ubco-cscott/499/README.md

# 499 Capstone Project - Group 16
Connor, Ellis, Nathan, Sarah, Sean
