ubco-cscott/499/PCB Files/406MHz detector/406MHz detector.pdf

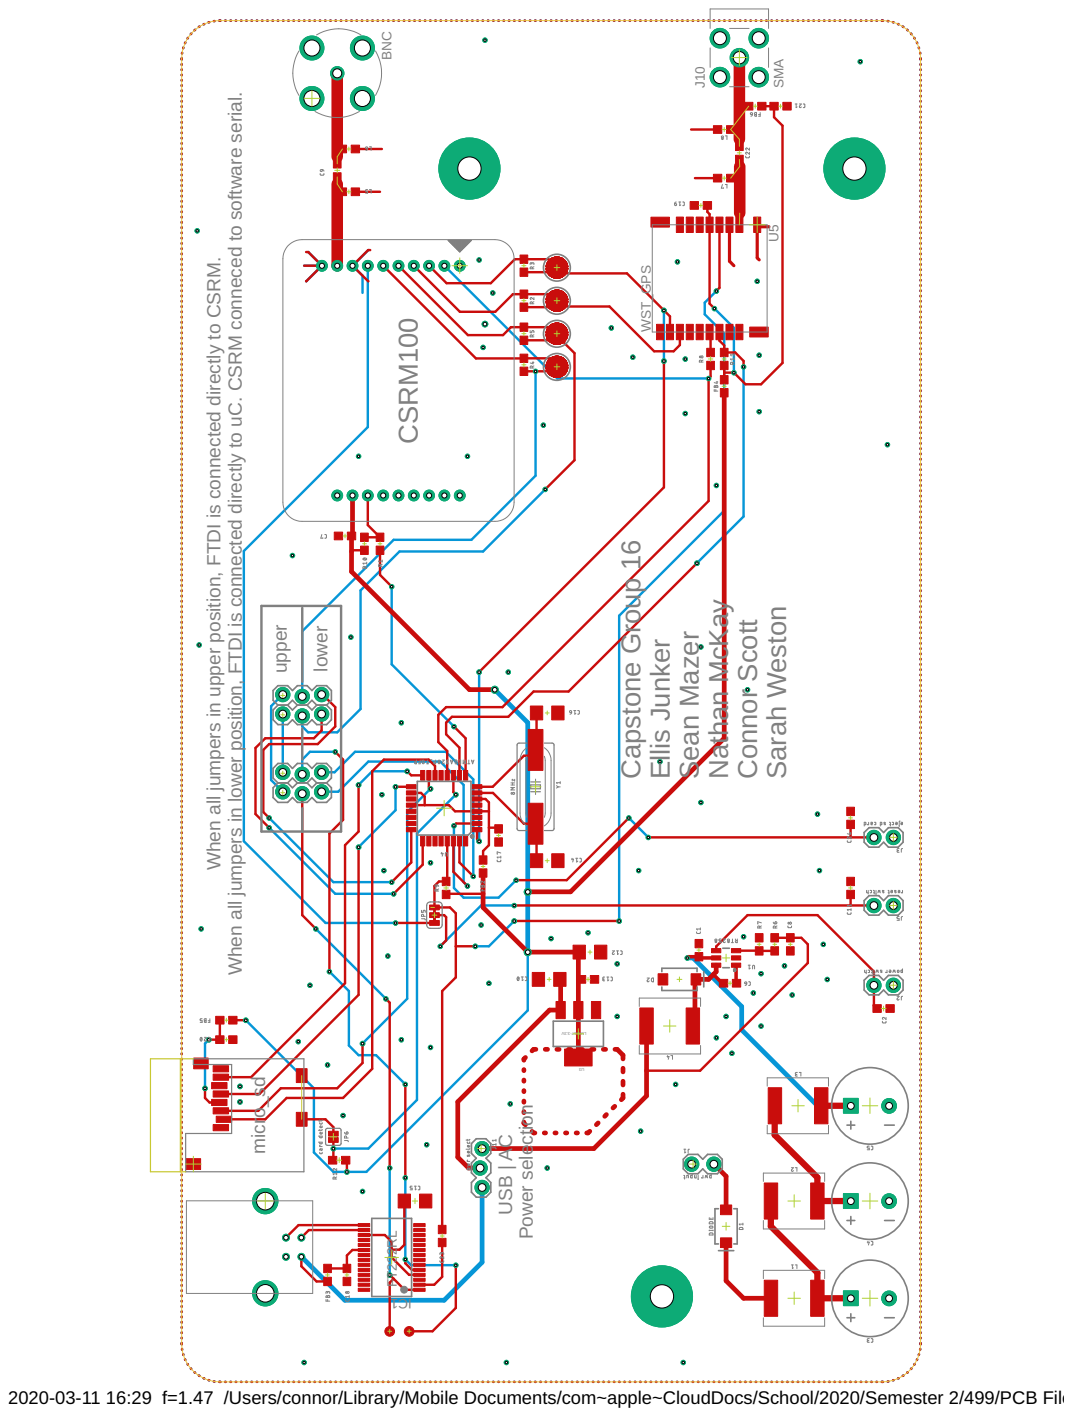
[picture p1: page 1]

er When all jum

2020-03-11 16:29 f=1.47 /Users/connor/Library/Mobile Documents/com~apple~CloudDocs/School/2020/Semester 2/499/PCB Files/406MHz detector/406MHz detector.brd
