ubco-cscott/499/PCB Files/406MHz detector/406MHz detector.brd

## EAGLE design PCB Files/406MHz detector/406MHz detector.brd (2020-03-17)

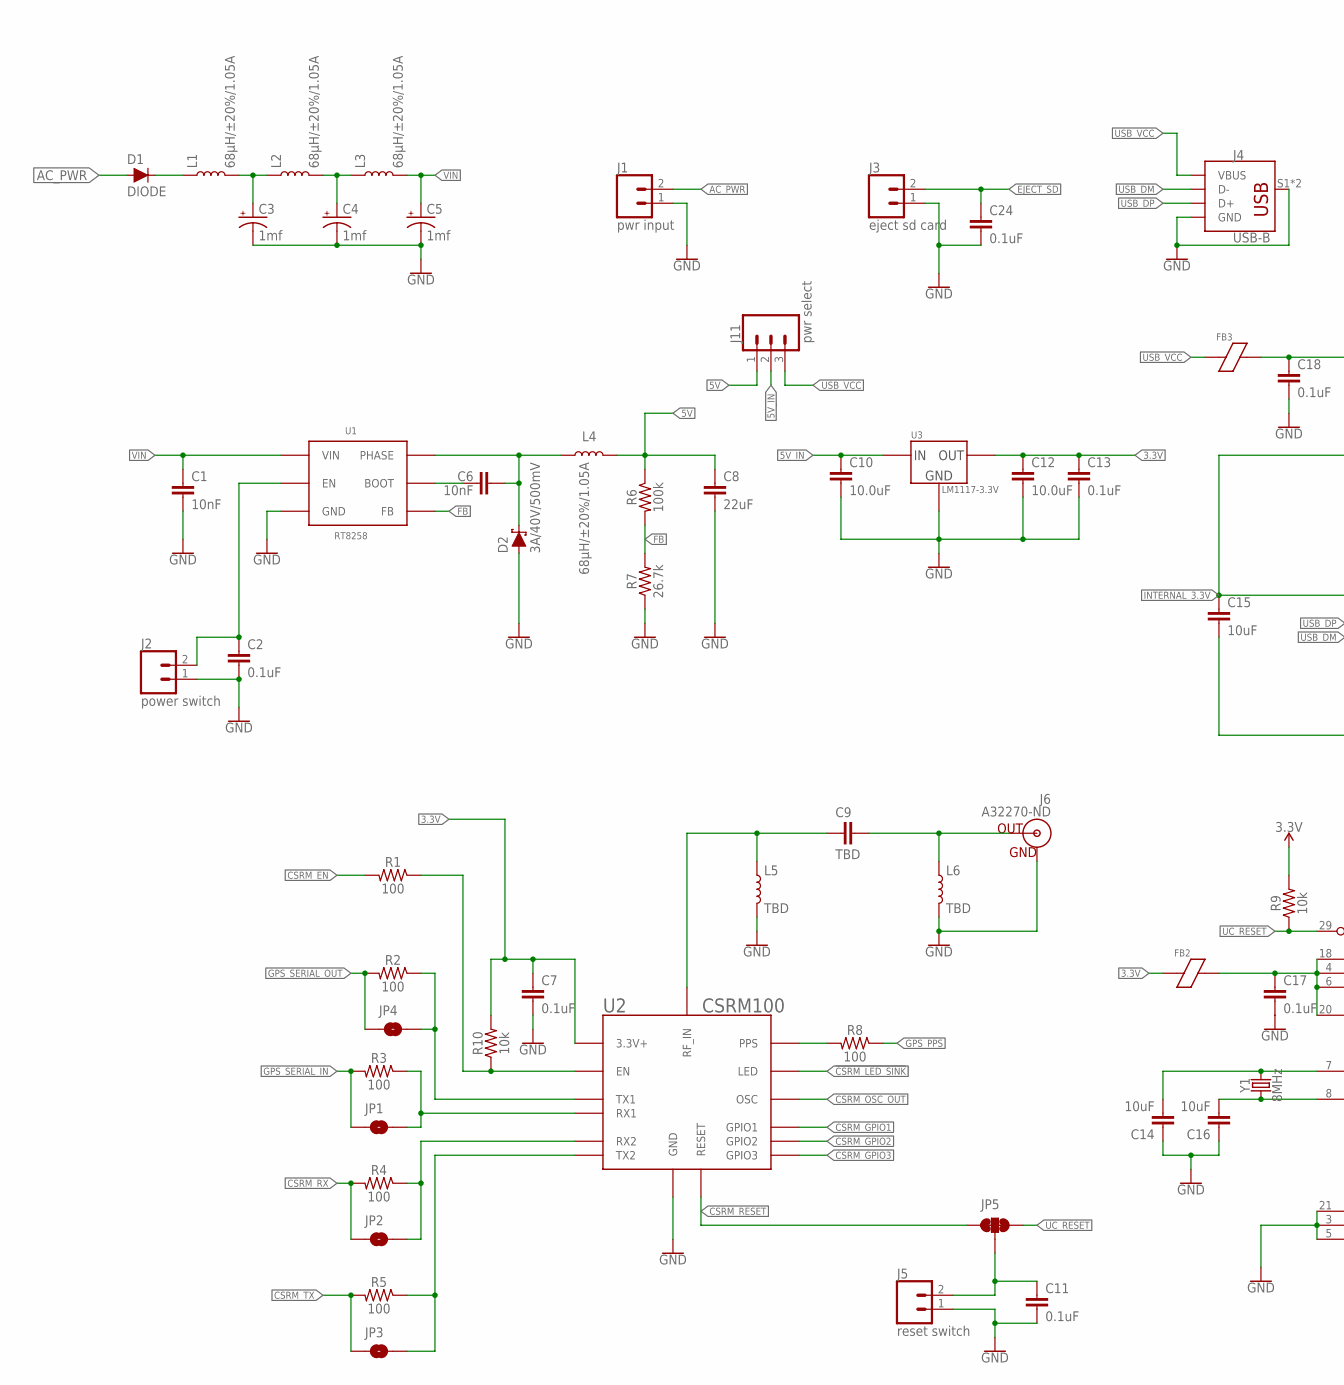
[picture p2: schematic 406MHz detector.sch, part in row 1, column 1]

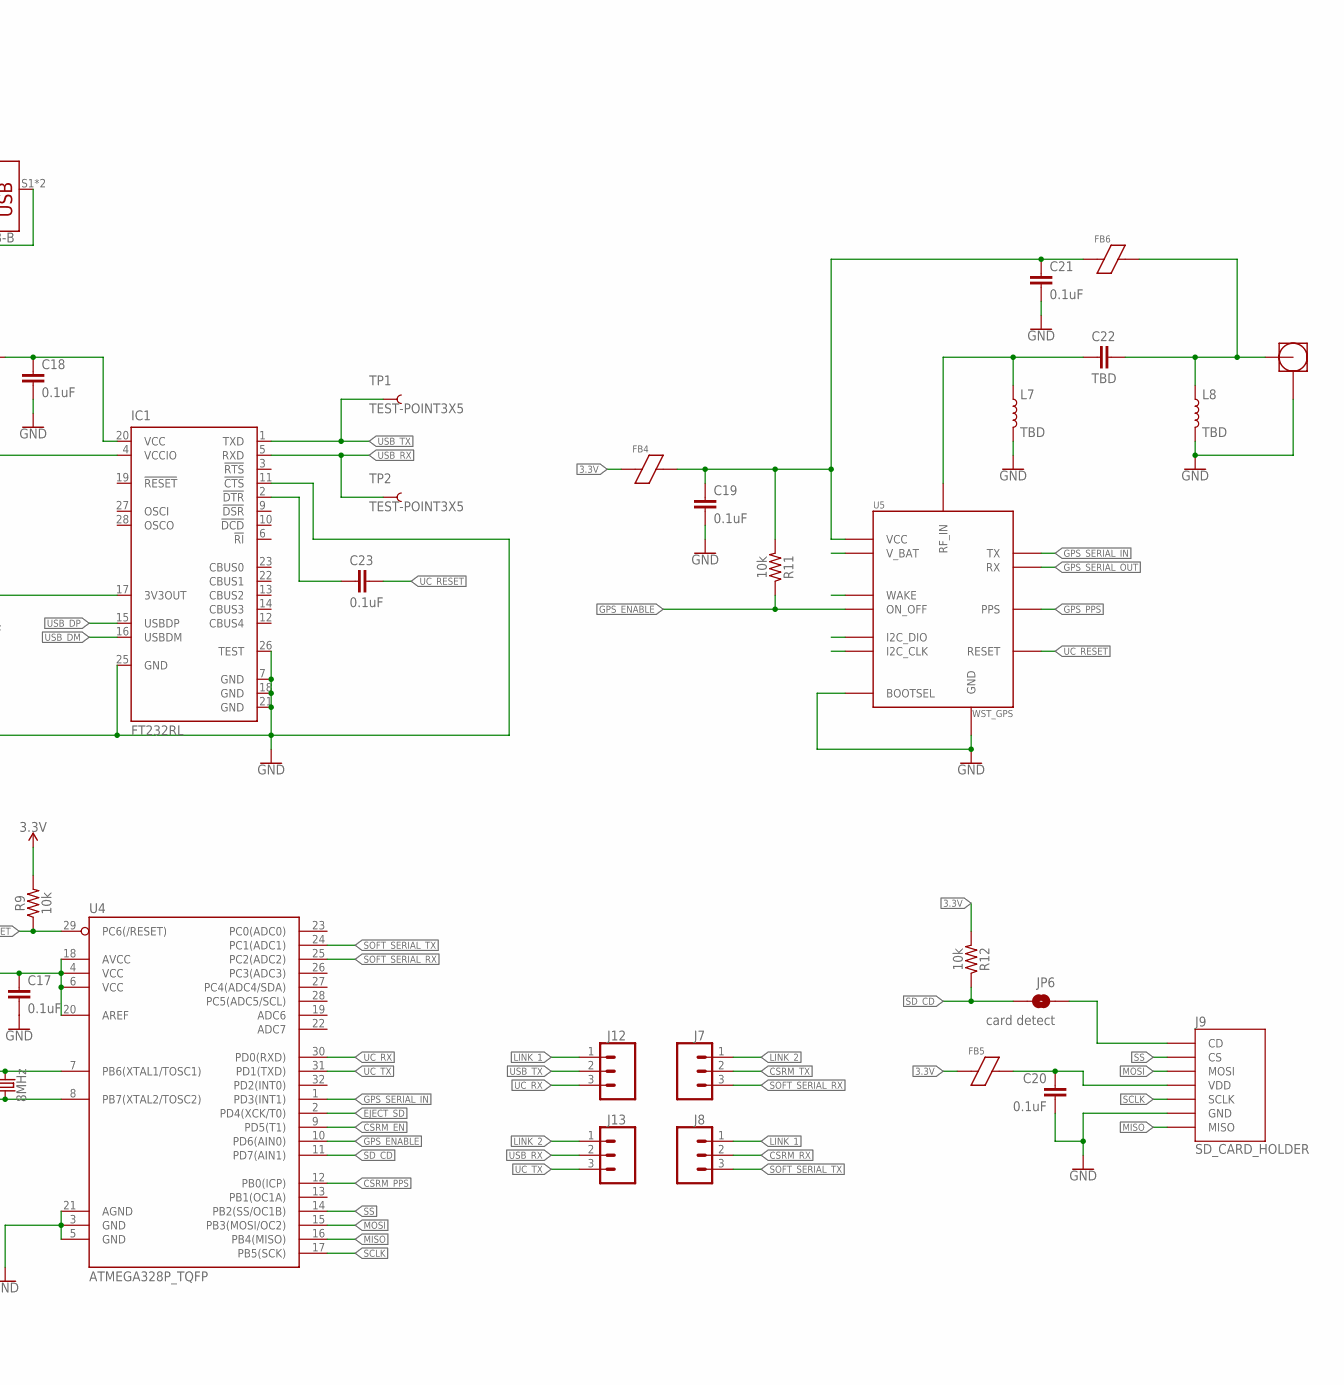
[picture p3: schematic 406MHz detector.sch, part in row 1, column 2]

Parts:
C1, C6: 10nF; 0603
C2, C7, C11, C13, C17, C18, C19, C20, C21, C23, C24: 0.1uF; 0603
C3, C4, C5: 1mf; CPOL-RADIAL-5MM-10MM-KIT
C8: 22uF; 0603
C9, C22: TBD; 0603
C10, C12: 10.0uF; 1206
C14, C15, C16: 10uF; 1206
D1: DIODE; SMA-DIODE
D2: 3A/40V/500mV; SMA-DIODE
FB2, FB3, FB4, FB5, FB6: FERRITE_BEAD; 0603
IC1: FT232RL; SSOP28
J1: pwr input; 1X02_LOCK
J2: power switch; 1X02
J3: eject sd card; 1X02
J4: USB-B; USB
J5: reset switch; 1X02
J6: A32270-ND; A33270-ND
J7, J8, J12, J13: select jumper; 1X03_LOCK
J9: SD_CARD_HOLDER
J10: SMA; SMA_R/A
J11: pwr select; 1X03_LOCK
JP1, JP2, JP3, JP4: JUMPER-SMT_2_NO_SILK_ROUND; SMT-JUMPER_2_NO_SILK_ROUND
JP5: JUMPER-SMT_3_2-NC_TRACE_SILK; SMT-JUMPER_3_2-NC_TRACE_SILK
JP6: card detect; SMT-JUMPER_2_NO_SILK
L1, L2, L3, L4: 68µH/±20%/1.05A; CR75
L5, L6, L7, L8: TBD; 0603
R1, R2, R3, R4, R5, R8: 100; 0603
R6: 100k; 0603
R7: 26.7k; 0603
R9, R10, R11, R12: 10k; 0603
TP1, TP2: TEST-POINT3X5; PAD.03X.05
U1: RT8258; SOT23-6
U2: CSRM100; CSRM
U3: LM1117-3.3V; SOT223
U4: ATMEGA328P_TQFP; TQFP32-08
U5: WST_GPS
Y1: 8MHz; HC49UP

Connections:
3.3V: C7.1, C12.1, C13.1, FB2.1, FB4.1, FB5.1, R9.2, R10.2, R12.2, U2.PWR_IN (3.3V+), U3.2 (VOUT), U3.4 (VOUT)
5V: C8.1, J11.1, L4.P$2 (2), R6.1
5V_IN: C10.1, J11.2, U3.3 (VIN)
406_IN: C9.2, L5.1, U2.406_IN (RF_IN)
!CSRM_LED_SINK: U2.LED
AC_PWR: D1.A, J1.2
ANTENNA_CONNECTOR: C9.1, J6.OUT, L6.1
BOOT: C6.1, U1.1 (BOOT)
CSRM_EN: R1.2, U4.9 (PD5(T1))
CSRM_GPIO1: U2.GPIO1
CSRM_GPIO2: U2.GPIO2
CSRM_GPIO3: U2.GPIO3
CSRM_OSC_OUT: U2.OSC_OUT (OSC)
CSRM_PPS: R8.2, U2.PPS, U4.12 (PB0(ICP))
CSRM_RESET: JP5.1, U2._RESET (RESET)
CSRM_RX: J8.2, JP2.1, R4.2
CSRM_TX: J7.2, JP3.1, R5.2
EJECT_SD: C24.1, J3.2, U4.2 (PD4(XCK/T0))
FB: R6.2, R7.2, U1.3 (FB)
GND: C1.2, C2.2, C3.-, C4.-, C5.-, C7.2, C8.2, C10.2, C11.2, C12.2, C13.2, C14.1, C15.2, C16.1, C17.2, C18.2, C19.2, C20.2, C21.2, C24.2, D2.A, IC1.7 (GND), IC1.11 (!CTS), IC1.18 (GND), IC1.21 (GND), IC1.25 (GND), IC1.26 (TEST), J1.1, J2.1, J3.1, J4.4 (GND), J4.S1 (SHIELD), J4.S2 (SHIELD), J5.1, J6.GND1 (GND), J6.GND2 (GND), J6.GND3 (GND), J6.GND4 (GND), J9.GND1 (GND), J9.GND2 (GND), J9.P6 (GND), J10.P$2, J10.P$3, J10.P$4, J10.P$5, L5.2, L6.2, L7.2, L8.2, R7.1, U1.2 (GND), U2.GND, U2.GND1 (GND), U2.GND2 (GND), U2.GND3 (GND), U2.GND4 (GND), U3.1 (GND), U4.3 (GND), U4.5 (GND), U4.21 (AGND), U5.P$1 (GND), U5.P$3 (GND), U5.P$9 (BOOTSEL), U5.P$17 (GND), U5.P$18 (GND), U5.P$19 (GND)
GPS_ANTENNA: C22.2, L7.1, U5.P$2 (RF_IN)
GPS_CONNECTOR: C22.1, FB6.2, J10.P$1, L8.1
GPS_ENABLE: R11.1, U4.10 (PD6(AIN0)), U5.P$15 (ON_OFF)
GPS_PPS: R8.1, U5.P$14 (PPS)
GPS_SERIAL_IN: JP1.1, R3.2, U4.1 (PD3(INT1)), U5.P$10 (TX)
GPS_SERIAL_OUT: JP4.1, R2.2, U5.P$11 (RX)
HF_SWITCH: C6.2, D2.C, L4.P$1 (1), U1.6 (PHASE)
INTERNAL_3.3V: C15.1, IC1.4 (VCCIO), IC1.17 (3V3OUT)
LINK_1: J8.1, J12.1
LINK_2: J7.1, J13.1
MISO: J9.P7 (MISO), U4.16 (PB4(MISO))
MOSI: J9.P3 (MOSI), U4.15 (PB3(MOSI/OC2))
unnamed: JP4.2, R2.1, U2.TX1
unnamed: JP1.2, R3.1, U2.RX1
unnamed: JP2.2, R4.1, U2.RX2
unnamed: JP3.2, R5.1, U2.TX2
unnamed: R1.1, R10.1, U2.EN
unnamed: C23.1, IC1.2 (!DTR)
unnamed: J9.CD1 (CD), J9.CD2 (CD), JP6.1
unnamed: D1.C, L1.P$1 (1)
unnamed: C3.+, L1.P$2 (2), L2.P$1 (1)
unnamed: C4.+, L2.P$2 (2), L3.P$1 (1)
unnamed: C18.1, FB3.1, IC1.20 (VCC)
unnamed: C14.2, U4.7 (PB6(XTAL1/TOSC1)), Y1.2
unnamed: C16.2, U4.8 (PB7(XTAL2/TOSC2)), Y1.1
unnamed: C19.1, C21.1, FB4.2, FB6.1, R11.2, U5.P$5 (VCC)
unnamed: C17.1, FB2.2, U4.4 (VCC), U4.6 (VCC), U4.18 (AVCC), U4.20 (AREF)
unnamed: C20.1, FB5.2, J9.P4 (VDD)
RESET: C11.1, J5.2, JP5.2
SCLK: J9.P5 (SCLK), U4.17 (PB5(SCK))
SD_CD: JP6.2, R12.1, U4.11 (PD7(AIN1))
SOFT_SERIAL_RX: J7.3, U4.25 (PC2(ADC2))
SOFT_SERIAL_TX: J8.3, U4.24 (PC1(ADC1))
SS: J9.P2 (CS), U4.14 (PB2(SS/OC1B))
SUPPLY_ENABLE: C2.1, J2.2, U1.4 (EN)
UC_RESET: C23.2, JP5.3, R9.1, U4.29 (PC6(/RESET)), U5.P$4 (RESET)
UC_RX: J12.3, U4.30 (PD0(RXD))
UC_TX: J13.3, U4.31 (PD1(TXD))
USB_DM: IC1.16 (USBDM), J4.2 (D-)
USB_DP: IC1.15 (USBDP), J4.3 (D+)
USB_RX: IC1.5 (RXD), J13.2, TP2.P$1
USB_TX: IC1.1 (TXD), J12.2, TP1.P$1
USB_VCC: FB3.2, J4.1 (VBUS), J11.3
VIN: C1.1, C5.+, L3.P$2 (2), U1.5 (VIN)

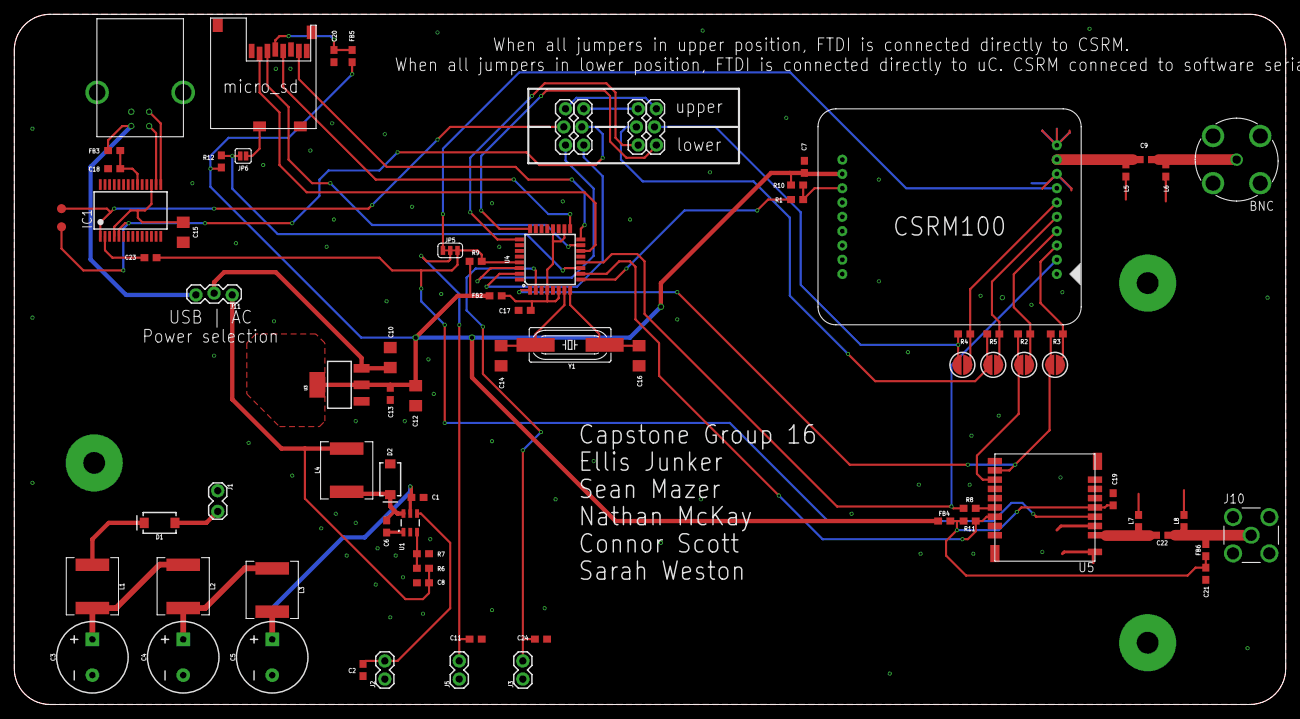
[picture p4: board 406MHz detector.brd from above]

Board: 2 copper layers, 177.8 x 96.5 mm, 79 parts (0 on the bottom side), 59 nets.
