ubco-cscott/499/Switching regulator test board/smps test.brd

## EAGLE design Switching regulator test board/smps test.brd (2020-01-20)

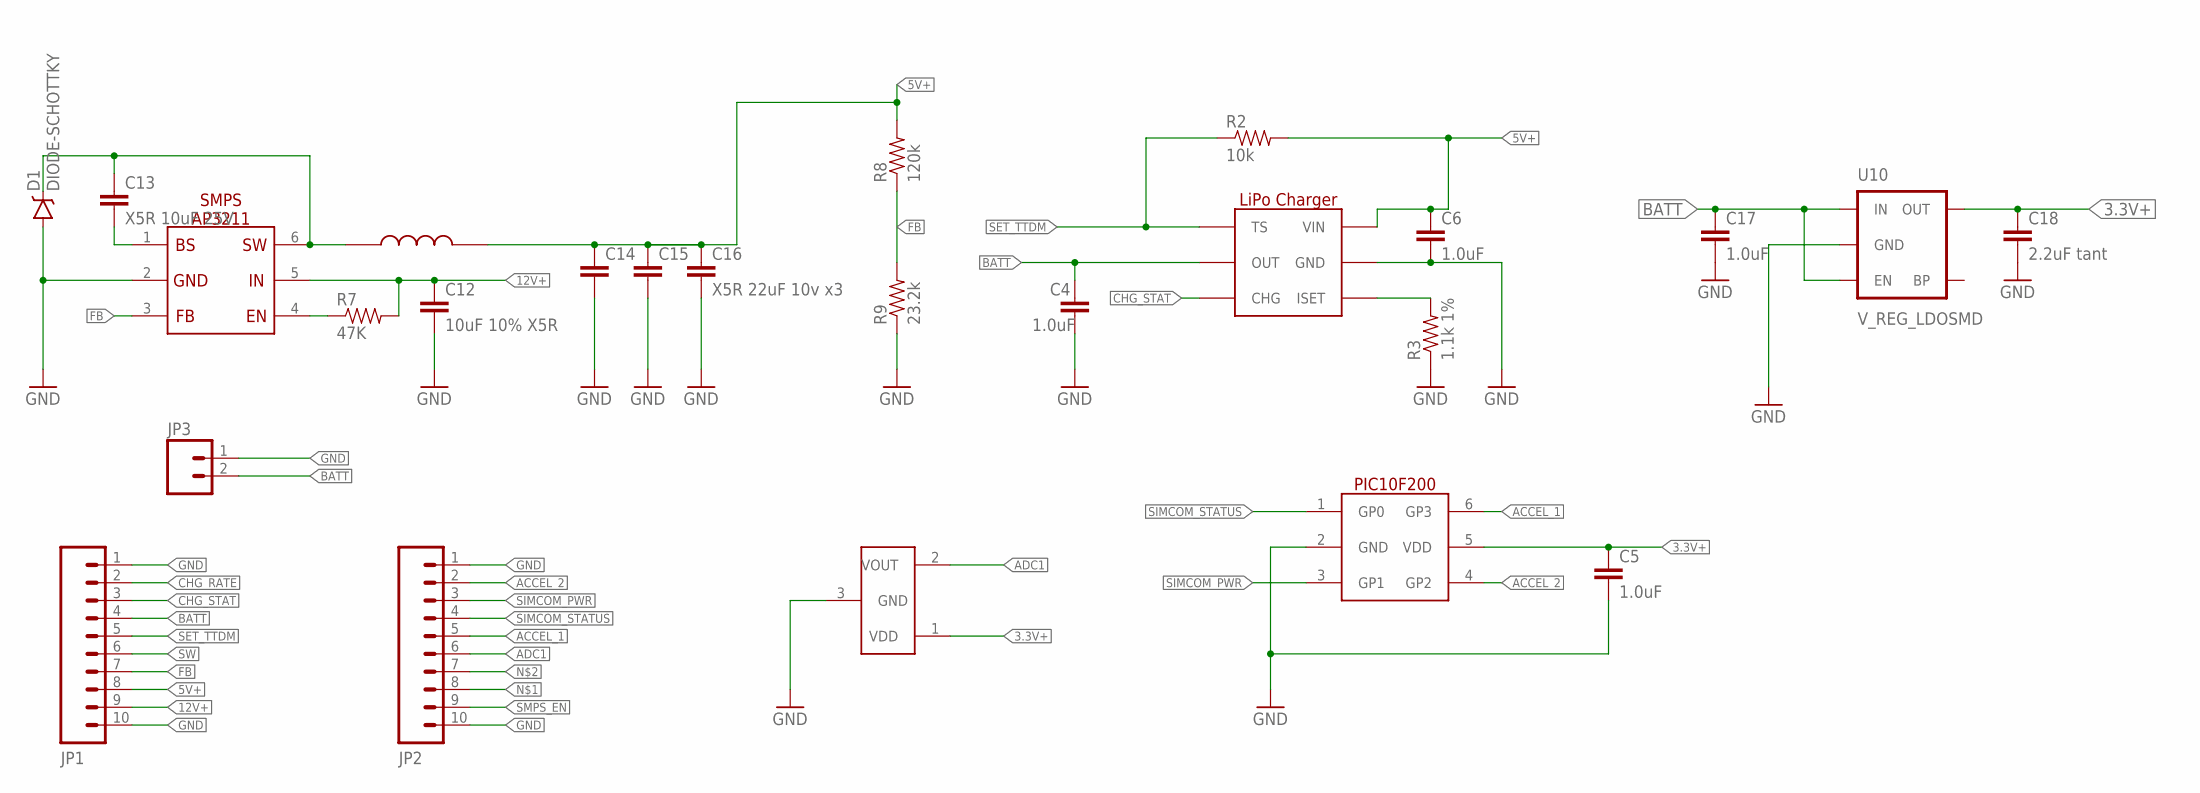
[picture p5: schematic smps test.sch]

Parts:
C4, C5, C6, C17: 1.0uF; 0603-CAP
C12: 10uF 10% X5R; 1206
C13: X5R 10uF 25V; 0603-CAP
C14, C15: CAP0603-CAP; 0603-CAP
C16: X5R 22uF 10v x3; 0603-CAP
C18: 2.2uF tant; 0603-CAP
D1: DIODE-SCHOTTKY; MICRO_SMP
JP1, JP2: M10LOCK; 1X10_LOCK
JP3: M02-JST-2MM-SMT; JST-2-SMD
R2: 10k; 0603-RES
R3: 1.1k 1%; 0603-RES
R7: 47K; 0603-RES
R8: 120k; 0603-RES
R9: 23.2k; 0603-RES
U3: BQ21040; SOT23-6
U6: PIC10F200; SOT23-6
U10: V_REG_LDOSMD; SOT23-5
U$1: MCP9700T-E; SOT23-3
U$2: AP3211; SOT23-6
U$4: INDUCTOR; INDUCTOR_FIXED

Connections:
3.3V+: C5.1, C18.1, U6.5 (VDD), U10.5 (OUT), U$1.1 (VDD)
5V+: C6.1, C14.1, C15.1, C16.1, JP1.8, R2.2, R8.2, U3.6 (VIN), U$4.P$2
12V+: C12.1, JP1.9, R7.2, U$2.5
ACCEL_1: JP2.5, U6.6 (GP3)
ACCEL_2: JP2.2, U6.4 (GP2)
ADC1: JP2.6, U$1.2 (VOUT)
BATT: C4.1, C17.1, JP1.4, JP3.2 (1), U3.2 (OUT), U10.1 (IN), U10.3 (EN)
CHG_RATE: JP1.2, R3.2, U3.4 (ISET)
CHG_STAT: JP1.3, U3.3 (CHG)
FB: JP1.7, R8.1, R9.2, U$2.3
GND: C4.2, C5.2, C6.2, C12.2, C14.2, C15.2, C16.2, C17.2, C18.2, D1.P$2 (A), JP1.1, JP1.10, JP2.1, JP2.10, JP3.1 (2), R3.1, R9.1, U3.5 (GND), U6.2 (GND), U10.2 (GND), U$1.3 (GND), U$2.2
unnamed: C13.2, U$2.1
SET_TTDM: JP1.5, R2.1, U3.1 (TS)
SIMCOM_PWR: JP2.3, U6.3 (GP1)
SIMCOM_STATUS: JP2.4, U6.1 (GP0)
SMPS_EN: JP2.9, R7.1, U$2.4
SW: C13.1, D1.P$1 (C), JP1.6, U$2.6, U$4.P$1

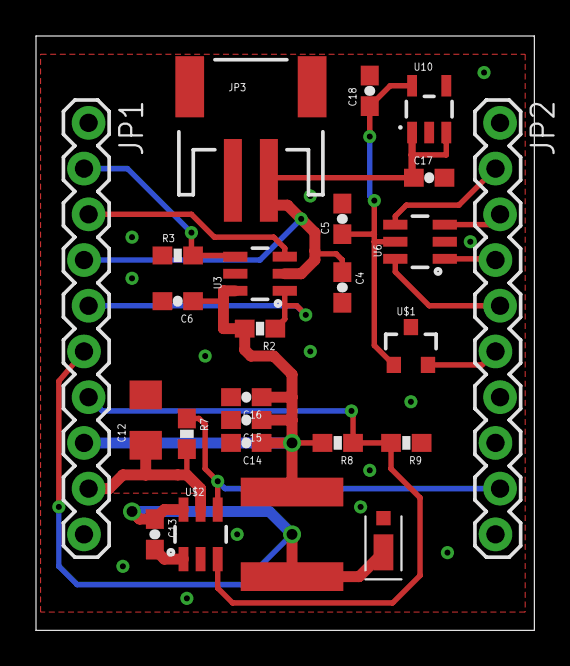
[picture p6: board smps test.brd from above]

Board: 2 copper layers, 27.7 x 33.0 mm, 25 parts (0 on the bottom side), 17 nets.
