ubco-cscott/499/Results/GED_21 Mar 2020.csv

 | Time Stamp | LUT ID | Satellite ID | Pass ID | Type | Beacon ID | Rx Time | Time Offset (ns) | Frequency (Hz) | Freq Offset (Hz) | Freq Bandwidth (Hz) | CNR (dB-Hz) | SNR (dB-Hz) | Mod Index (rad) | Short Msg Index | FS Message Index | FS Bit Offset | Bit Errors Fsynch | Bit Rate (bps) | Beacon Message
1 | 2020/081 22:44:11.869 | 3166 | 217 | 759 | 1 | A79C0 00000 00001 | 2020/081 22:44:11.869 | 0 | 406062420.5 | 0 | 2.861 | 41.072 | 43.665 | 1.254 | 0.246 | 0 | 78 | 0 | 400.037 | FFFE2F 53CE00 000000 000D14 8E508E 32A51A
2 | 2020/081 22:43:19.658 | 3166 | 217 | 759 | 1 | A79C0 00000 00001 | 2020/081 22:43:19.658 | 0 | 406062420.3 | 0 | 2.861 | 40.647 | 43.005 | 1.261 | 0.265 | 0 | 78 | 0 | 400.022 | FFFE2F 53CE00 000000 000D14 8E5094 AA9D74
3 | 2020/081 22:40:50.888 | 3166 | 217 | 759 | 1 | A79C0 00000 00001 | 2020/081 22:40:50.888 | 0 | 406062420.8 | 0 | 2.861 | 30.989 | 32.629 | 1.289 | 0.287 | 0 | 79 | 0 | 399.929 | FFFE2F 53CE00 000000 000D14 8E50D4 513003
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
