ubco-cscott/499/Results/GOW2_21 Mar 2020.csv

 | Time Stamp | LUT ID | Satellite ID | Pass ID | Type | Beacon ID | Rx Time | Time Offset (ns) | Frequency (Hz) | Freq Offset (Hz) | Freq Bandwidth (Hz) | CNR (dB-Hz) | SNR (dB-Hz) | Mod Index (rad) | Short Msg Index | FS Message Index | FS Bit Offset | Bit Errors Fsynch | Bit Rate (bps) | Beacon Message
1 | 2020/081 22:44:11.868 | 3169 | 216 | 1226 | 0001 | A79C0 00000 00001 | 2020/081 22:44:11.868 | 0 | 406034220.711 | 0.000 | 2.861 | 40.066 | 41.785 | 1.257 | 0.262 | 0 | 5000 | 0 | 399.975 | FFFE2F 53CE00 000000 000D14 8E506A 64BB3D
2 | 2020/081 22:43:19.657 | 3169 | 216 | 1226 | 0001 | A79C0 00000 00001 | 2020/081 22:43:19.657 | 0 | 406034220.641 | 0.000 | 2.861 | 40.830 | 41.927 | 1.251 | 0.238 | 0 | 5000 | 0 | 400.022 | FFFE2F 53CE00 000000 000D14 8E500B AC9E8C
3 | 2020/081 22:40:50.888 | 3169 | 216 | 1226 | 0001 | A79C0 00000 00001 | 2020/081 22:40:50.888 | 0 | 406034221.336 | 0.000 | 2.861 | 41.251 | 42.597 | 1.279 | 0.249 | 0 | 5000 | 0 | 400.022 | FFFE2F 53CE00 070000 000D14 8E500F C05C25
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
