ubco-cscott/499/Results/LCH_21 Mar 2020.csv

 | Time Stamp | LUT ID | Satellite ID | Pass ID | Type | Beacon ID | Rx Time | Time Offset (ns) | Frequency (Hz) | Freq Offset (Hz) | Freq Bandwidth (Hz) | CNR (dB-Hz) | SNR (dB-Hz) | Mod Index (rad) | Short Msg Index | FS Message Index | FS Bit Offset | Bit Errors Field1 | Bit Errors Field2 | Bit Errors Fsynch | Bit Rate (bps) | Beacon Message
1 | 2020/081 21:44:18.936 | 3162 | 12 | 57304 | 0001 | A79C0 00000 00001 | 2020/081 21:44:18.936 | 0 | 406027021.656 | 0.000 | 10.490 | 32.810 | 37.794 | 1.295 | 0.303 | 0 | 6094 | 9 | 9 | 0 | 399.975 | FFFE2F 53CE00 000000 000D14 8E50F1 021573
2 | 2020/081 19:32:55.775 | 3162 | 11 | 69642 | 0001 | A79C0 00000 00001 | 2020/081 19:32:55.775 | 0 | 406026682.531 | 0.000 | 10.490 | 45.731 | 47.555 | 1.238 | 0.557 | 0 | 78 | 9 | 9 | 0 | 399.991 | FFFE2F 53CE00 000000 000D14 8E50E5 25B095
3 | 2020/081 19:32:05.925 | 3162 | 11 | 69642 | 0001 | A79C0 00000 00001 | 2020/081 19:32:05.925 | 0 | 406028160.938 | 0.000 | 11.444 | 45.711 | 47.502 | 1.243 | 0.527 | 0 | 78 | 9 | 9 | 0 | 400.022 | FFFE2F 53CE00 000000 000D14 8E50F8 2E9A75
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
