ubco-cscott/499/Results/LED_21 Mar 2020.csv

 | Time Stamp | LUT ID | Satellite ID | Pass ID | Type | Beacon ID | Rx Time | Time Offset (ns) | Frequency (Hz) | Freq Offset (Hz) | Freq Bandwidth (Hz) | CNR (dB-Hz) | SNR (dB-Hz) | Mod Index (rad) | Short Msg Index | FS Message Index | FS Bit Offset | Bit Errors Field1 | Bit Errors Field2 | Bit Errors Fsynch | Bit Rate (bps) | Beacon Message
1 | 2020/081 21:44:18.939 | 3163 | 12 | 57304 | 0001 | A79C0 00000 00001 | 2020/081 21:44:18.939 | 0 | 406027026.344 | 0.000 | 9.537 | 33.025 | 37.808 | 1.294 | 0.287 | 0 | 6093 | 9 | 9 | 0 | 400.022 | FFFE2F 53CE00 000000 000D14 8E50E1 026D79
2 | 2020/081 19:34:36.048 | 3163 | 11 | 69642 | 0001 | A79C0 00000 00001 | 2020/081 19:34:36.048 | 0 | 406024053.125 | 0.000 | 7.629 | 32.204 | 32.814 | 1.312 | 0.370 | 0 | 78 | 9 | 9 | 0 | 399.991 | FFFE2F 53CE00 000000 000D14 8E50A9 FC100D
3 | 2020/081 19:33:44.884 | 3163 | 11 | 69642 | 0001 | A79C0 00000 00001 | 2020/081 19:33:44.884 | 0 | 406025314.188 | 0.000 | 8.583 | 35.004 | 37.736 | 1.316 | 0.352 | 0 | -234 | 9 | 9 | 0 | 399.960 | FFFE2F 53CE00 000000 000D14 8F6F91 F220A5
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
