ubco-cscott/499/todo list.txt

- Wire up new microcontroller
- add sd card solt
- add jumpers for disconnecting and connecting the microcontroller.
