ubco-cscott/499/(commit log)

2020-01-20 eagle test board added
    [smps test.brd, smps test.sch]
2020-01-20 changed the name of the example PCB folder
    [smps test.brd, smps test.sch]
2020-01-21 added the PIC datasheet
    [406MHz detector.sch]
2020-01-21 eagle library and schematic updated
2020-01-21 I started on the converter
    [406MHz detector.sch]
2020-01-22 Nathan made changes in 413 lecture finished the converter
    [406MHz detector.sch]
2020-01-23 added a package that models the CSRM100 receiver in library labaled capstone L1
    [406MHz detector.sch]
2020-01-25 added CSRM100 to capstone library, and schematic
2020-01-26 testing connor's branch
    [406MHz detector.sch]
2020-01-26 cleaned up some traces
2020-01-27 added led example
    [406MHz detector.sch]
2020-01-27 added led example nets
    [406MHz detector.sch]
2020-01-27 added seperate schematic areas for git merging
    [406MHz detector.sch]
2020-01-27 removed sample led changes
    [406MHz detector.sch]
2020-01-28 added boxes and labels to schematic for separating workspaces
    [406MHz detector.sch]
2020-01-28 removed problem with ground labels connecting to 3.3V net
    [406MHz detector.sch]
2020-01-28 added capactior to sw_reg enable input
    [406MHz detector.sch]
2020-01-28 added diode datasheet, added input filtering for aircraft power
    [406MHz detector.sch]
2020-02-04 changed uc, added crystal
    [406MHz detector.sch]
2020-02-05 components added to schematic
    [406MHz detector.sch]
2020-02-08 added ftdi adaptor, small schematic changes
    [406MHz detector.sch]
2020-02-08 small changes to PCB
    [406MHz detector.sch]
2020-02-09 added labels to usb pins
    [406MHz detector.sch]
2020-02-09 removed old footprints from library, added usb connector
    [406MHz detector.sch]
2020-02-09 added gps module to schematic
    [406MHz detector.sch]
2020-02-11 latest version of sch and brd
    [406MHz detector.brd, 406MHz detector.sch]
2020-02-12 ensuring updates are pushed
    [406MHz detector.brd, 406MHz detector.sch]
2020-02-12 latest update of schematic, sent to kevin for double check
    [406MHz detector.brd, 406MHz detector.sch]
2020-02-12 added p/n for ferrite bead
    [406MHz detector.sch]
2020-02-14 library changes, schematic changes, board changes
    [406MHz detector.brd, 406MHz detector.sch]
2020-02-15 final version of PCB to review
    [406MHz detector.brd, 406MHz detector.sch]
2020-03-17 added arduino code
    [406MHz detector.brd, 406MHz detector.sch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]
2020-03-22 new arduino sketch
2020-04-08 added satellite data
    [GED_21 Mar 2020.csv, GED_21 Mar 2020.xlsx, GOW2_21 Mar 2020.csv, LCH_21 Mar 2020.csv, LED_21 Mar 2020.csv, LGO_21 Mar 2020.csv]
